poojithas956/HackPad/CAD/HackPad.step

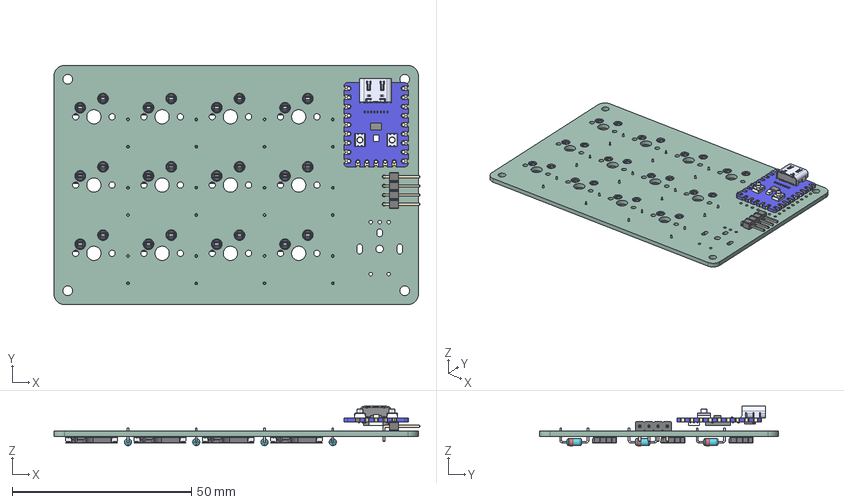
[picture p1: CAD file, 2026-10-12]
CAD/HackPad.step
102.1 x 66.7 x 11.0 mm
RP2040-ZERO
PinHeader_1x04_P2.54mm_Horizontal
D_DO-35_SOD27_P7.62mm_Horizontal x 12
HS_KS-2P02B01-01_MX x 12
HackPad_PCB
