poojithas956/HackPad/CAD/Base.step

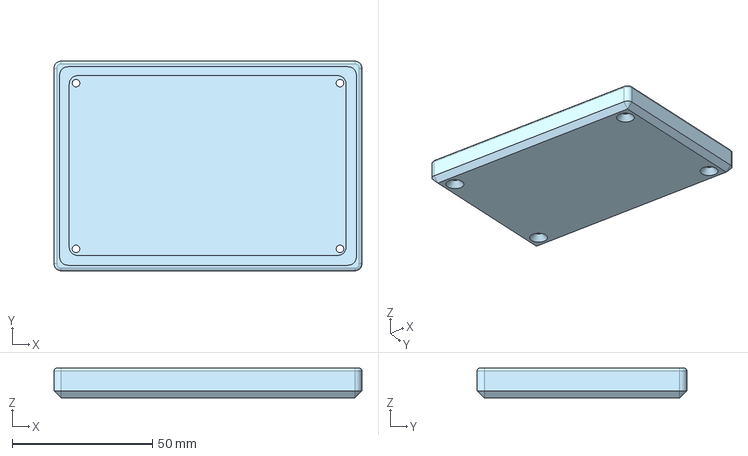
[picture p2: CAD file, 2026-10-12]
CAD/Base.step
109.7 x 74.7 x 10.6 mm
