poojithas956/HackPad/CAD/Plate.step

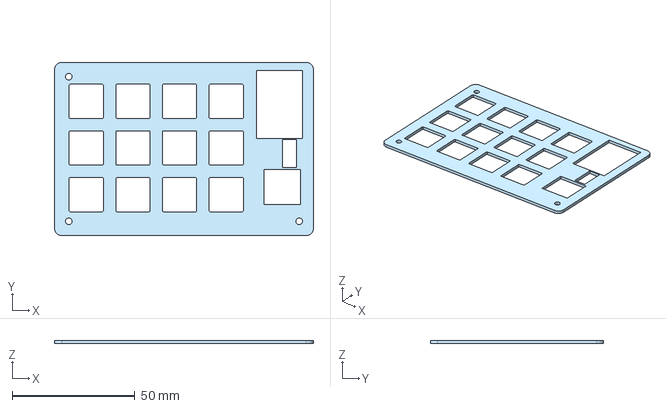
[picture p3: CAD file, 2026-10-12]
CAD/Plate.step
105.7 x 70.7 x 1.40 mm
