poojithas956/HackPad/PCB/HackPad.kicad_pcb

## KiCad design PCB/HackPad.kicad_pcb (2026-10-12)

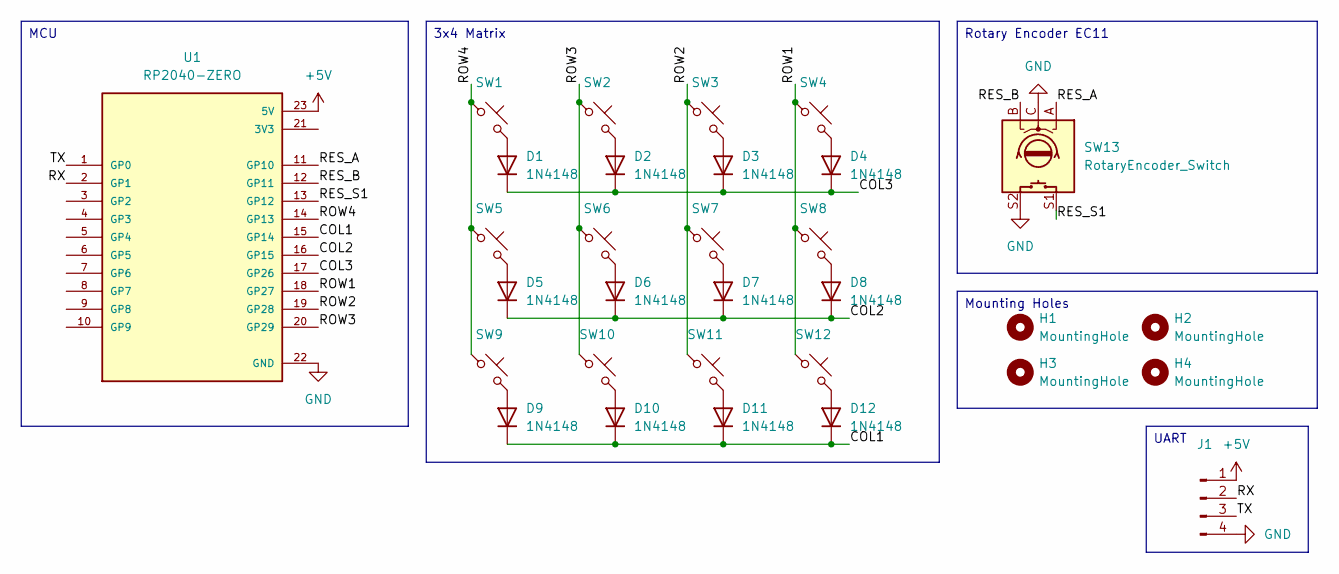
[picture p4: schematic HackPad.kicad_sch]

Parts:
D1, D2, D3, D4, D5, D6, D7, D8, D9, D10, D11, D12: 1N4148; D_DO-35_SOD27_P7.62mm_Horizontal
H1, H2, H3, H4: MountingHole; MountingHole_2.7mm_M2.5
J1: Conn_01x04_Pin; PinHeader_1x04_P2.54mm_Horizontal
SW1, SW2, SW3, SW4, SW5, SW6, SW7, SW8, SW9, SW10, SW11, SW12: SW_Push_45deg; SW_MX_HS_KS-2P02B01-01_1u
SW13: RotaryEncoder_Switch; RotaryEncoder_Alps_EC11E-Switch_Vertical_H20mm_MountingHoles
U1: RP2040-ZERO; MODULE_RP2040-ZERO; PARTREV NA

Connections:
+5V: J1.1, U1.23 (5V)
/COL1: D9.1 (K), D10.1 (K), D11.1 (K), D12.1 (K), U1.15 (GP14)
/COL2: D5.1 (K), D6.1 (K), D7.1 (K), D8.1 (K), U1.16 (GP15)
/COL3: D1.1 (K), D2.1 (K), D3.1 (K), D4.1 (K), U1.17 (GP26)
/RES_A: SW13.A, U1.11 (GP10)
/RES_B: SW13.B, U1.12 (GP11)
/RES_S1: SW13.S1, U1.13 (GP12)
/ROW1: SW4.1, SW8.1, SW12.1, U1.18 (GP27)
/ROW2: SW3.1, SW7.1, SW11.1, U1.19 (GP28)
/ROW3: SW2.1, SW6.1, SW10.1, U1.20 (GP29)
/ROW4: SW1.1, SW5.1, SW9.1, U1.14 (GP13)
/RX: J1.2, U1.2 (GP1)
/TX: J1.3, U1.1 (GP0)
GND: J1.4, SW13.C, SW13.S2, U1.22 (GND)
unnamed: D1.2 (A), SW1.2
unnamed: D2.2 (A), SW2.2
unnamed: D3.2 (A), SW3.2
unnamed: D4.2 (A), SW4.2
unnamed: D5.2 (A), SW5.2
unnamed: D6.2 (A), SW6.2
unnamed: D7.2 (A), SW7.2
unnamed: D8.2 (A), SW8.2
unnamed: D9.2 (A), SW9.2
unnamed: D10.2 (A), SW10.2
unnamed: D11.2 (A), SW11.2
unnamed: D12.2 (A), SW12.2

Notes on the sheet:
MCU
Mounting Holes
3x4 Matrix
UART
Rotary Encoder EC11

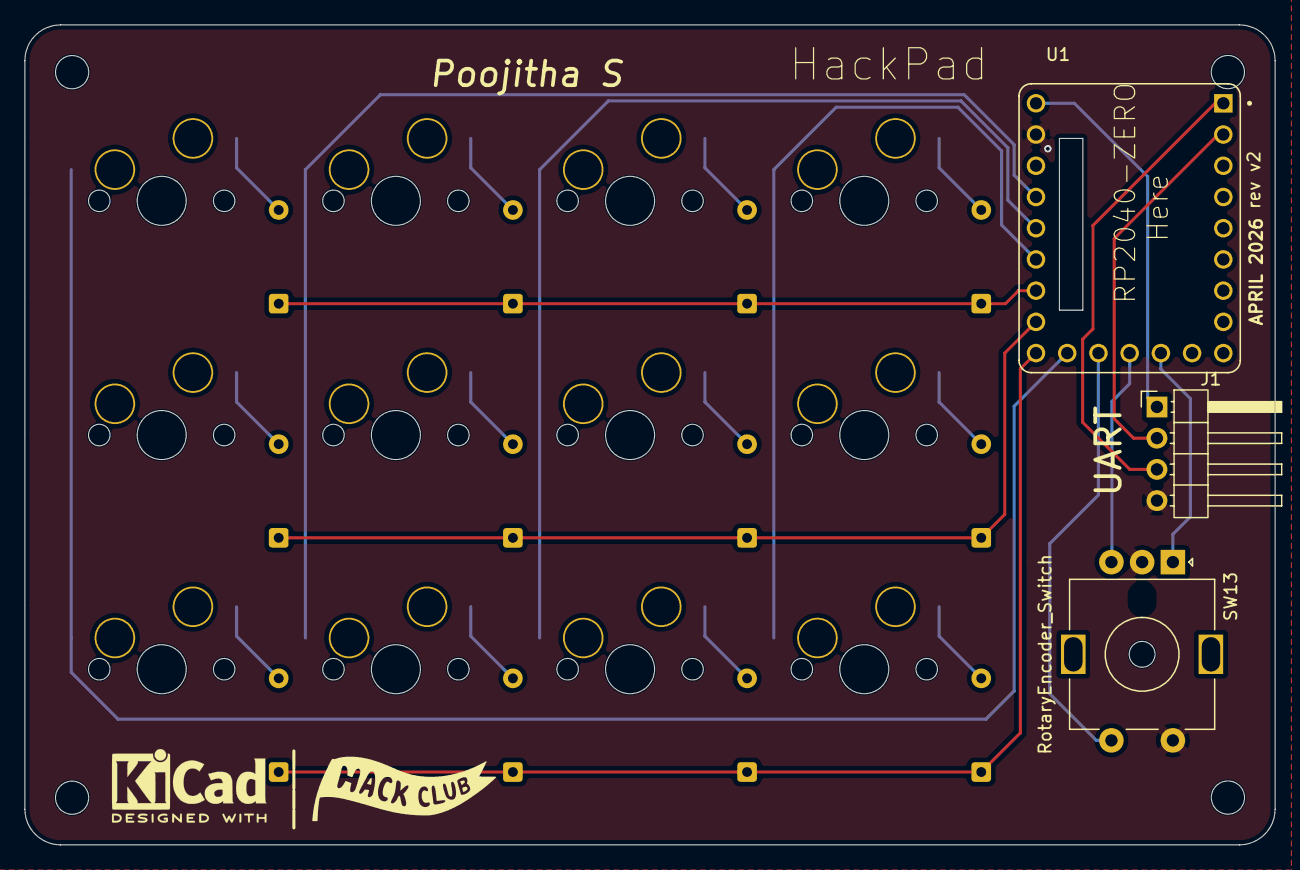
[picture p5: board HackPad.kicad_pcb from above]

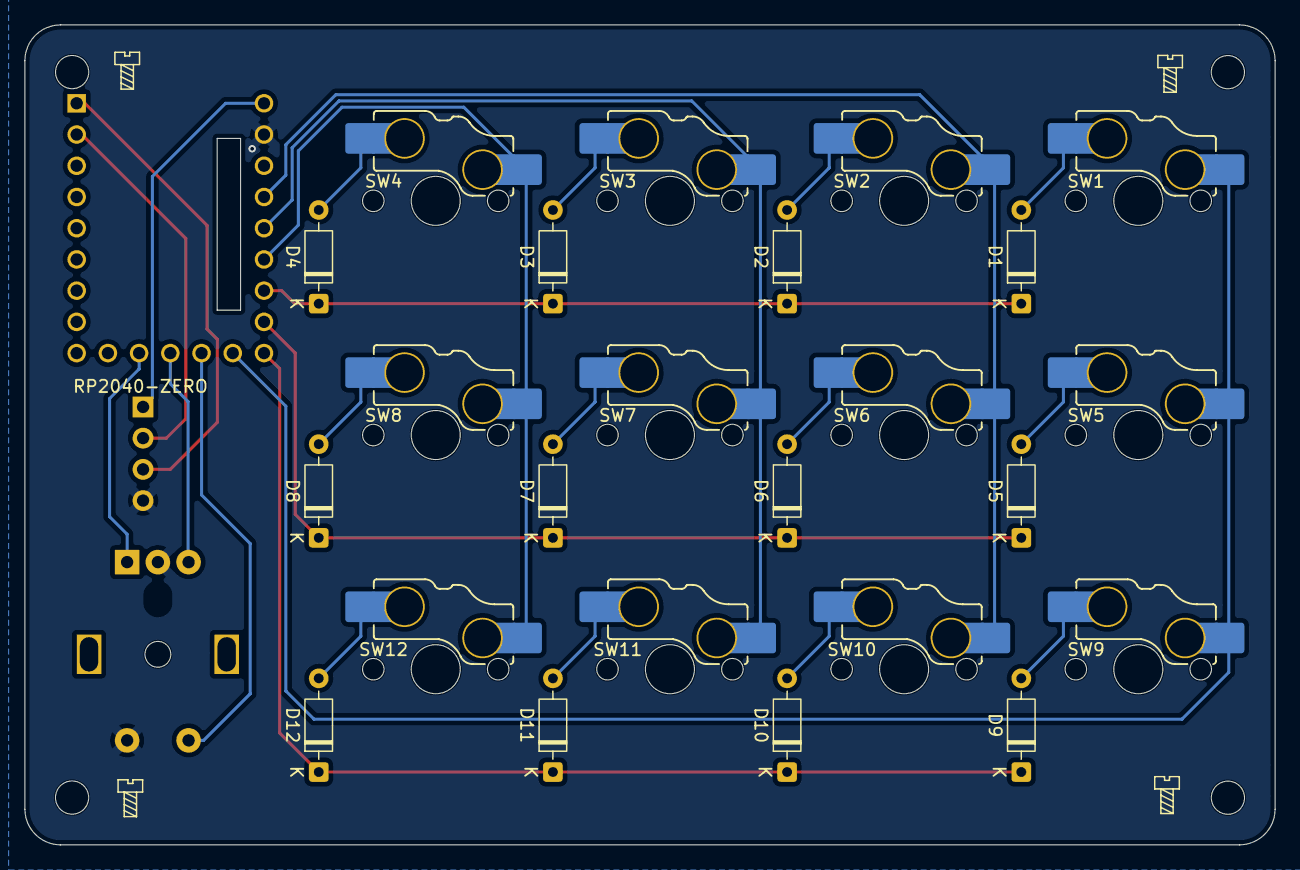
[picture p6: board HackPad.kicad_pcb from below]

Board: 2 copper layers, 101.7 x 66.7 mm, 33 parts (24 on the bottom side), 26 nets.

Other parts of the board:
H: MountingHole; MountingHole_2.7mm_M2.5
Pogo: LOGO; HackClub
